LKirchber/3D-printed-Hand/Bilder/Spule.jpg

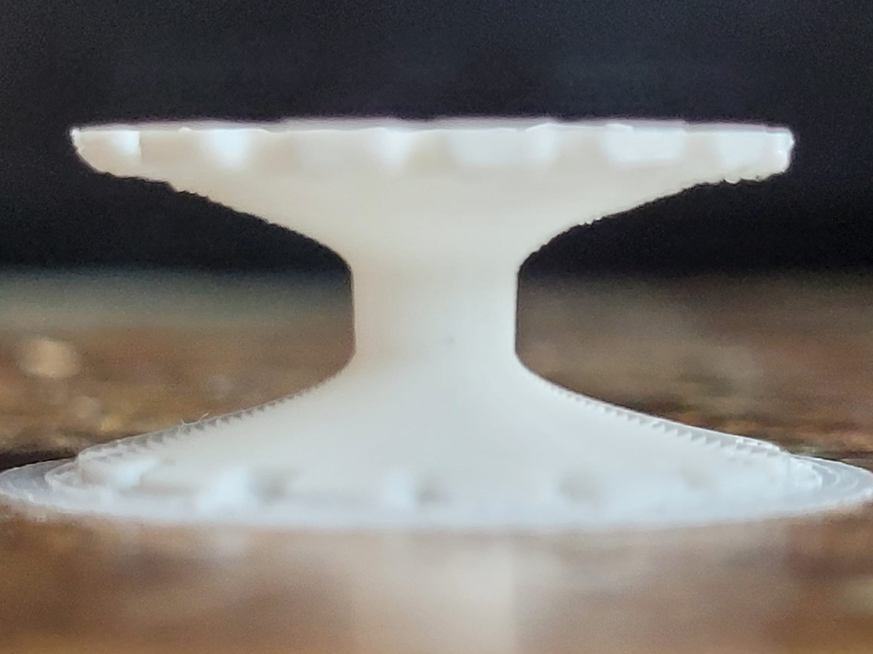
Bilder/Spule.jpg
