LKirchber/3D-printed-Hand/Bilder/Drucksensor lose.jpg

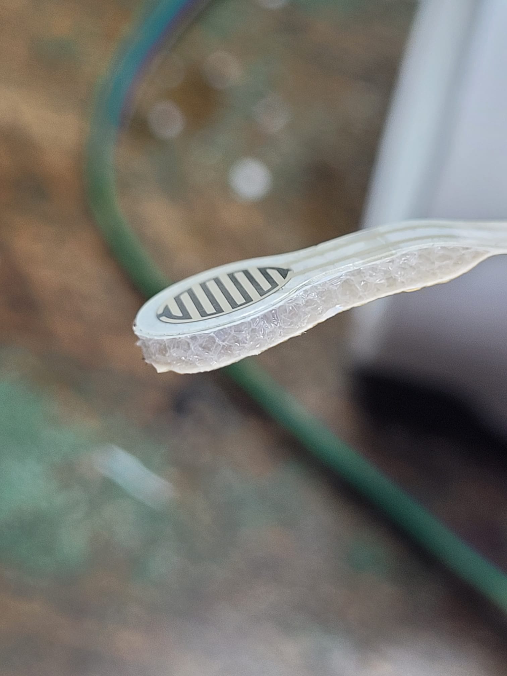
Bilder/Drucksensor lose.jpg
