LKirchber/3D-printed-Hand/Bilder/Bilder CAD/Finger 1 berührt Daumen.1.jpg

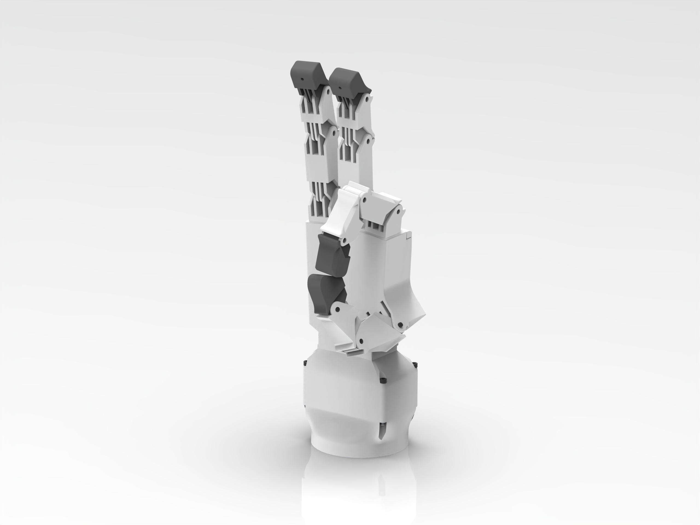
Bilder/Bilder CAD/Finger 1 berührt Daumen.1.jpg
