LKirchber/3D-printed-Hand/Bilder/Bilder CAD/Finger 2 berüht Daumen.1.jpg

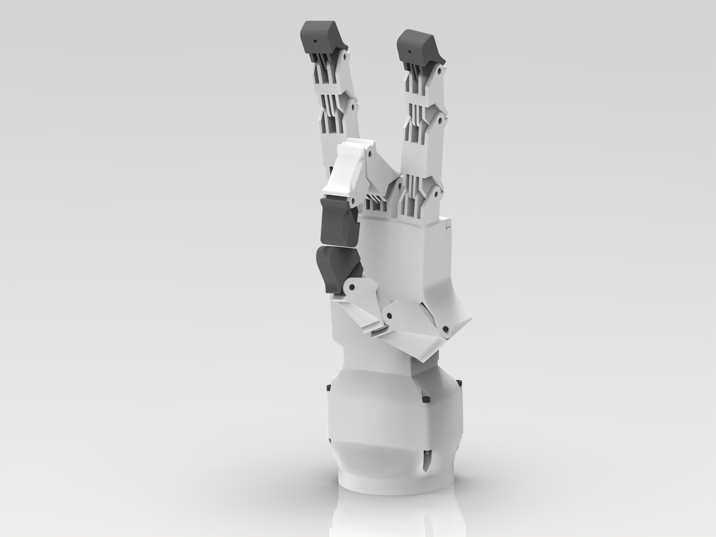
Bilder/Bilder CAD/Finger 2 berüht Daumen.1.jpg
