LKirchber/3D-printed-Hand/Bilder/Bilder CAD/Finger 3 berührt Daumen.1.jpg

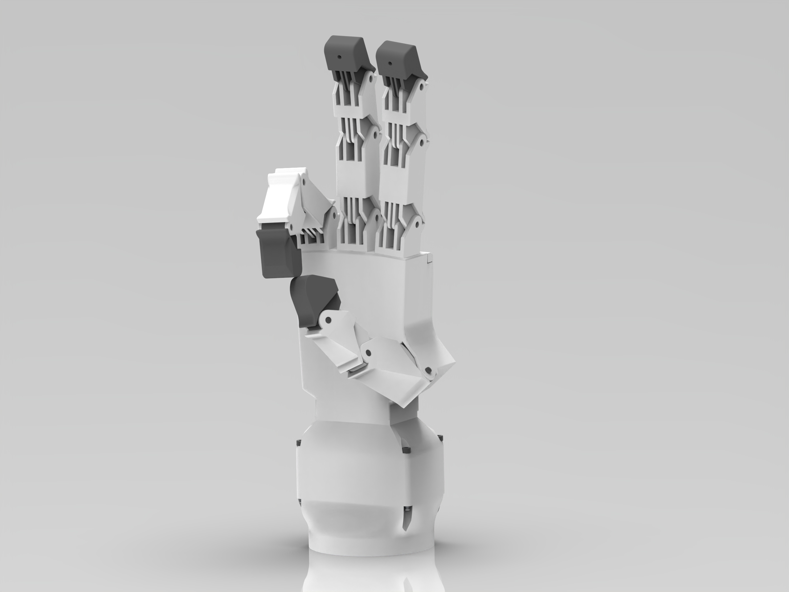
Bilder/Bilder CAD/Finger 3 berührt Daumen.1.jpg
