LKirchber/3D-printed-Hand/Bilder/Bilder CAD/Finger berühren Daumen.2.jpg

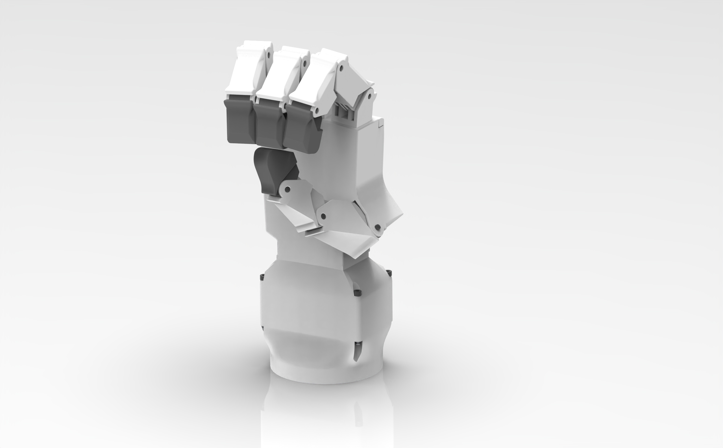
Bilder/Bilder CAD/Finger berühren Daumen.2.jpg
