LKirchber/3D-printed-Hand/Bilder/Bilder CAD/Hand ausgeklappt.1.jpg

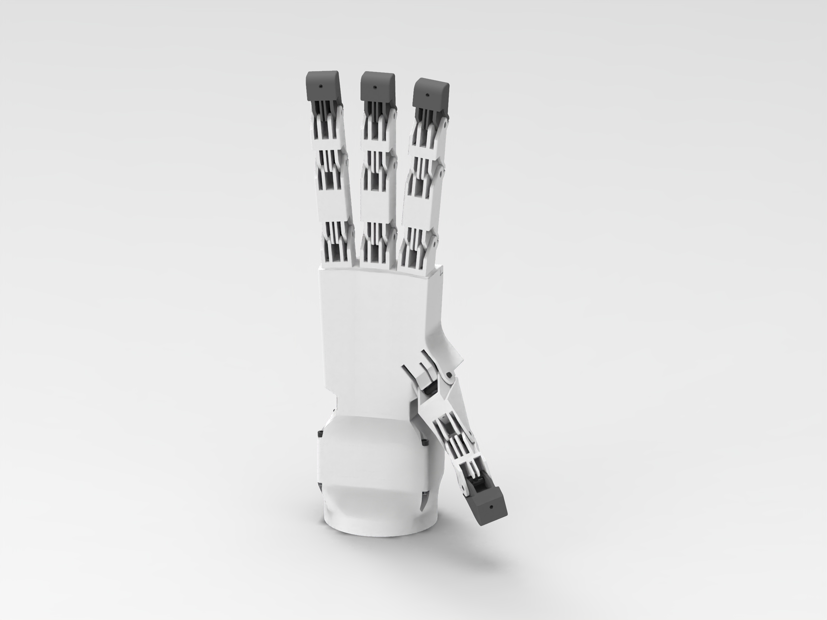
Bilder/Bilder CAD/Hand ausgeklappt.1.jpg
