LKirchber/3D-printed-Hand/Bilder/Bilder CAD/Hand geschlossen.1.jpg

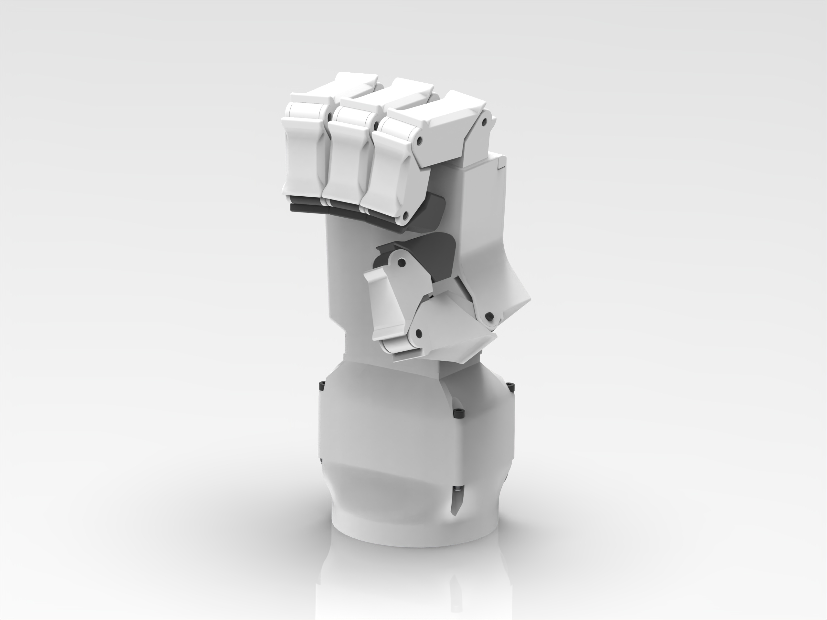
Bilder/Bilder CAD/Hand geschlossen.1.jpg
