LKirchber/3D-printed-Hand/Bilder/Bilder CAD/Hand Grundkörper.1.jpg

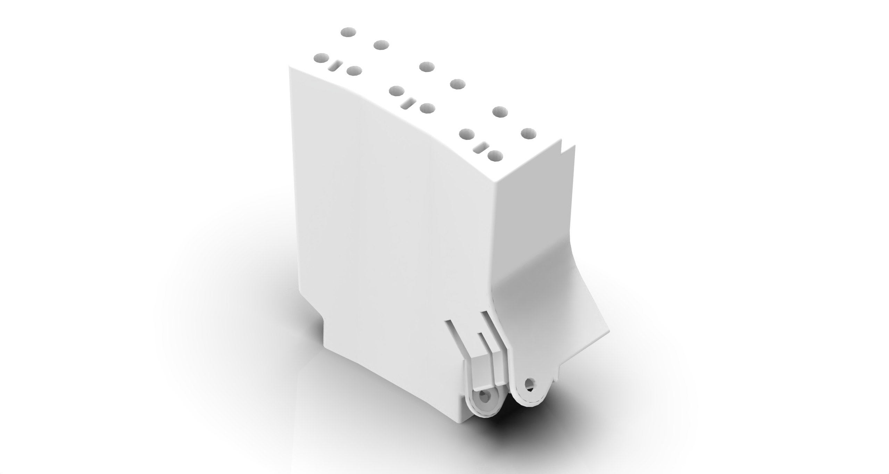
Bilder/Bilder CAD/Hand Grundkörper.1.jpg
