LKirchber/3D-printed-Hand/Bilder/Bilder CAD/Hand offen.1.jpg

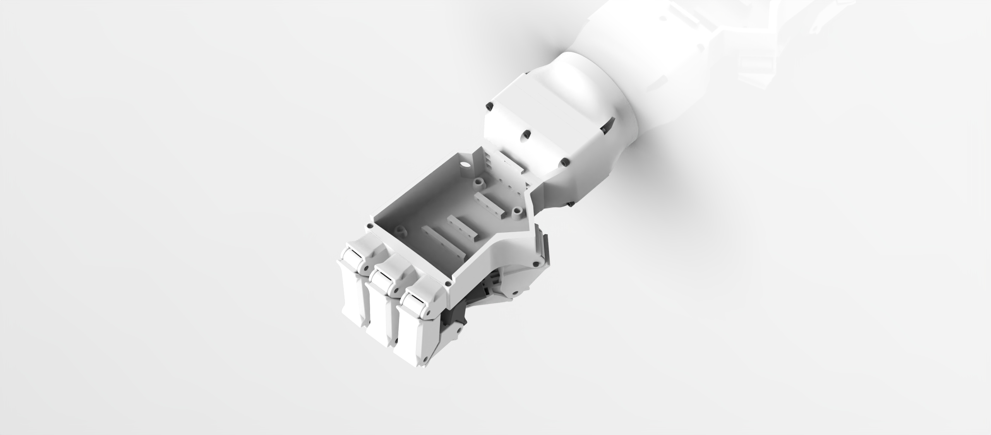
Bilder/Bilder CAD/Hand offen.1.jpg
