LKirchber/3D-printed-Hand/Bilder/Bilder CAD/Hand von hinten.1.jpg

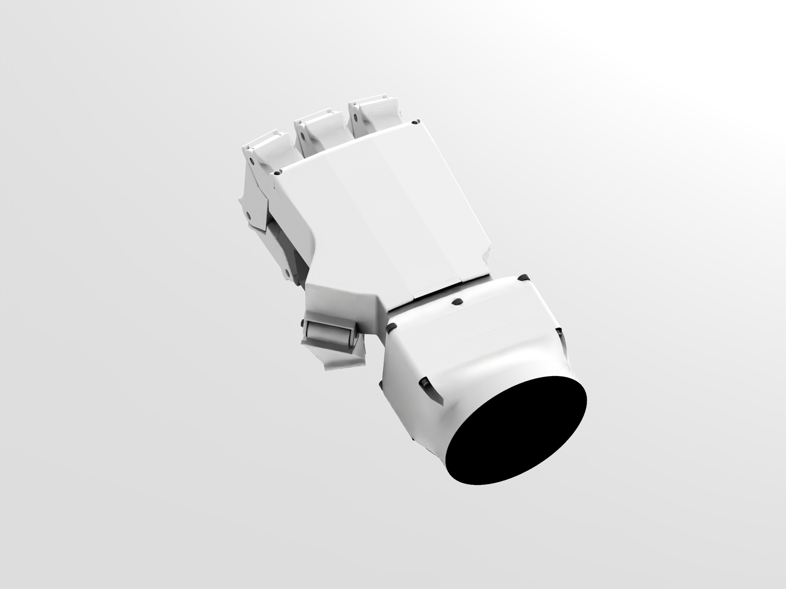
Bilder/Bilder CAD/Hand von hinten.1.jpg
