LKirchber/3D-printed-Hand/Bilder/Bilder CAD/selbst-bau-hand.jpg

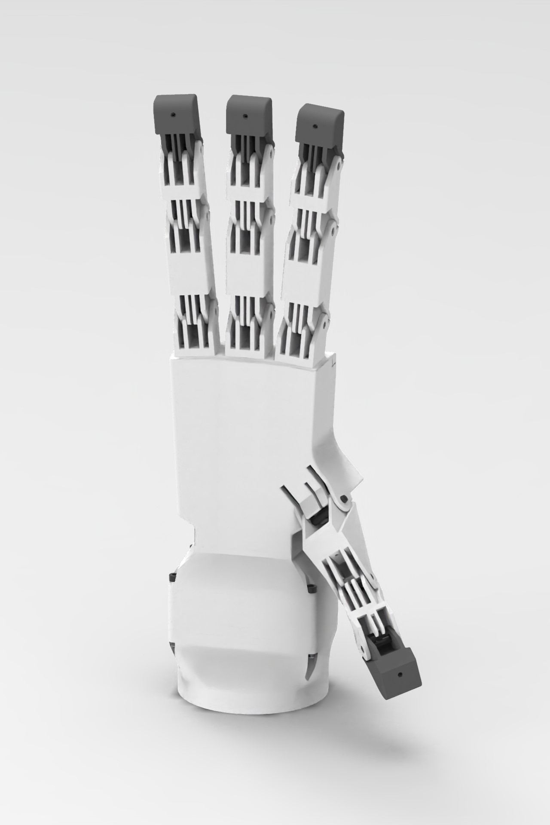
Bilder/Bilder CAD/selbst-bau-hand.jpg
