LKirchber/3D-printed-Hand/Bilder/Gewindeeinsatz.jpg

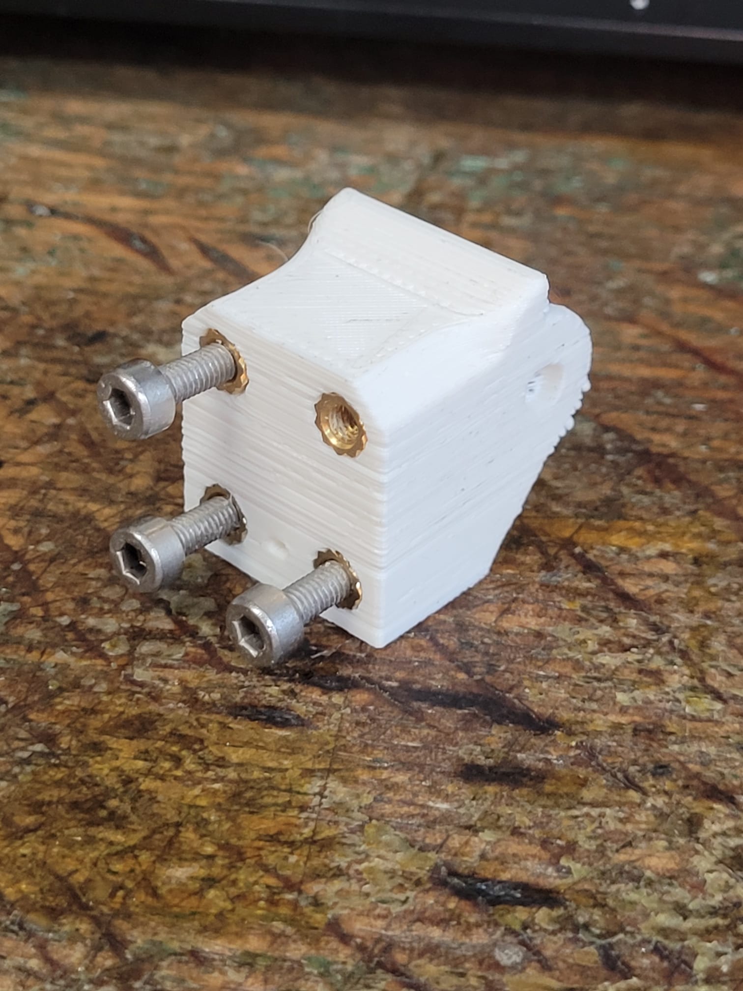
Bilder/Gewindeeinsatz.jpg
