LKirchber/3D-printed-Hand/Bilder/Verkabelung.jpg

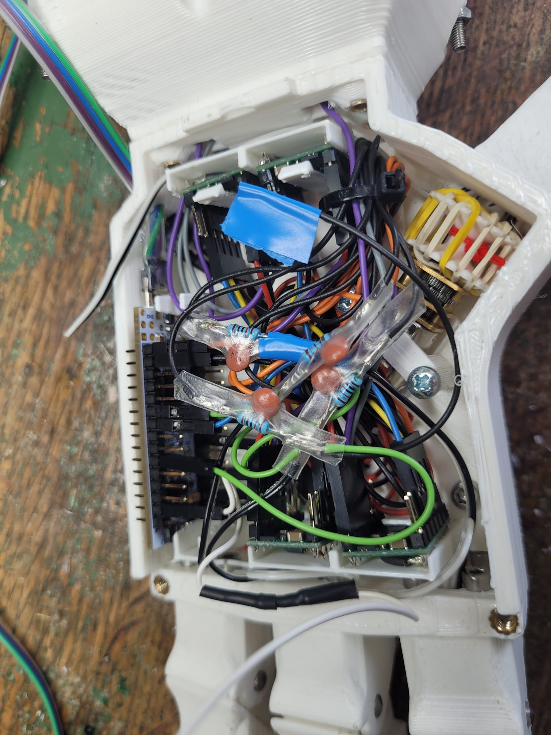
Bilder/Verkabelung.jpg
