LKirchber/3D-printed-Hand/schematics/scematics.png

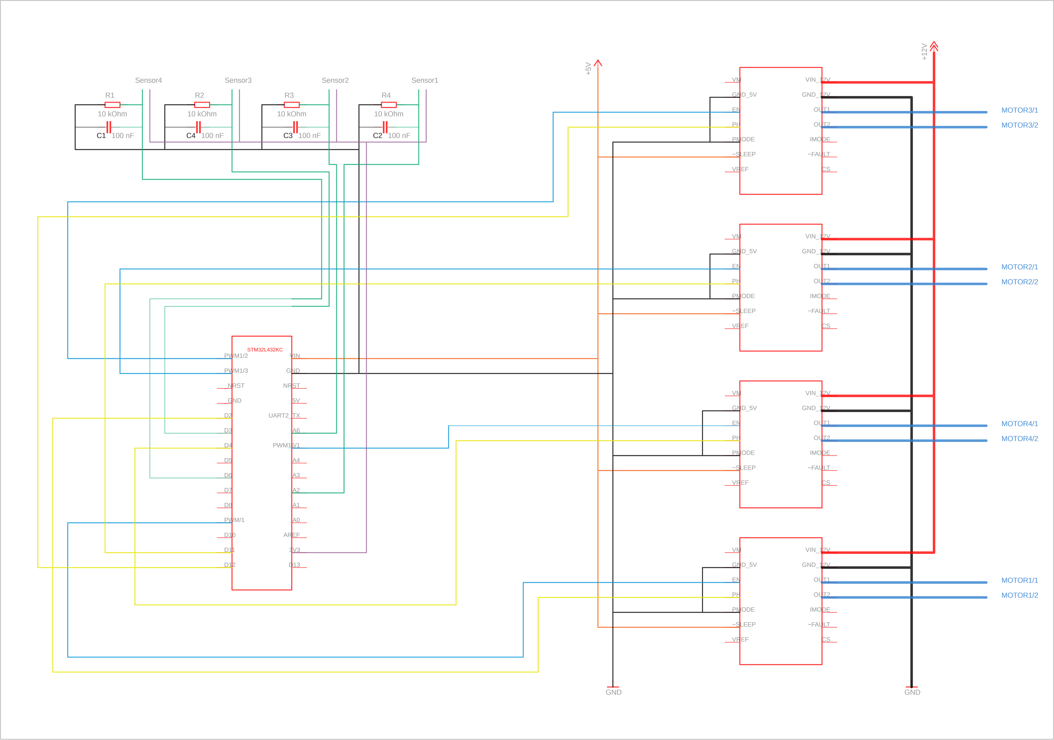
schematics/scematics.png
