LKirchber/3D-printed-Hand/CAD_selbstbau_hand/Daumen 4_Konzept 4-2.stp

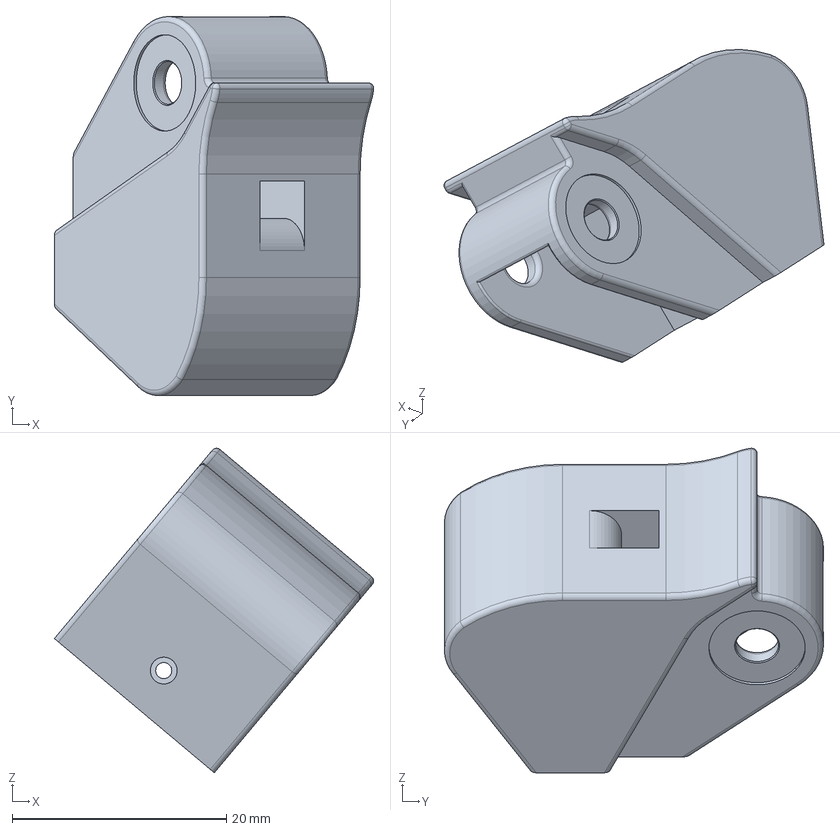
[picture p36: CAD file, 2023-01-17]
CAD_selbstbau_hand/Daumen 4_Konzept 4-2.stp
29.8 x 35.4 x 30.3 mm
