LKirchber/3D-printed-Hand/CAD_selbstbau_hand/hinge gen01 female.stp

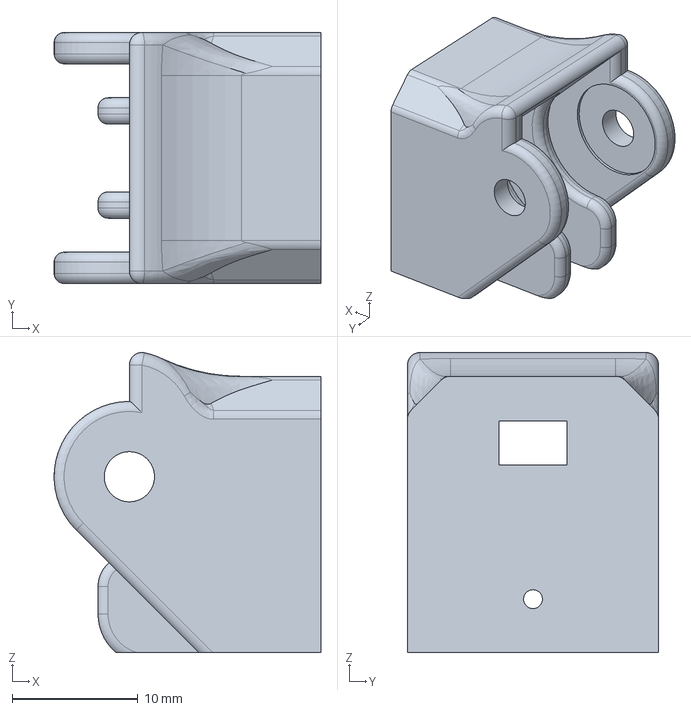
[picture p37: CAD file, 2023-01-17]
CAD_selbstbau_hand/hinge gen01 female.stp
21.2 x 20.0 x 23.9 mm
