LKirchber/3D-printed-Hand/CAD_selbstbau_hand/federhalter.stp

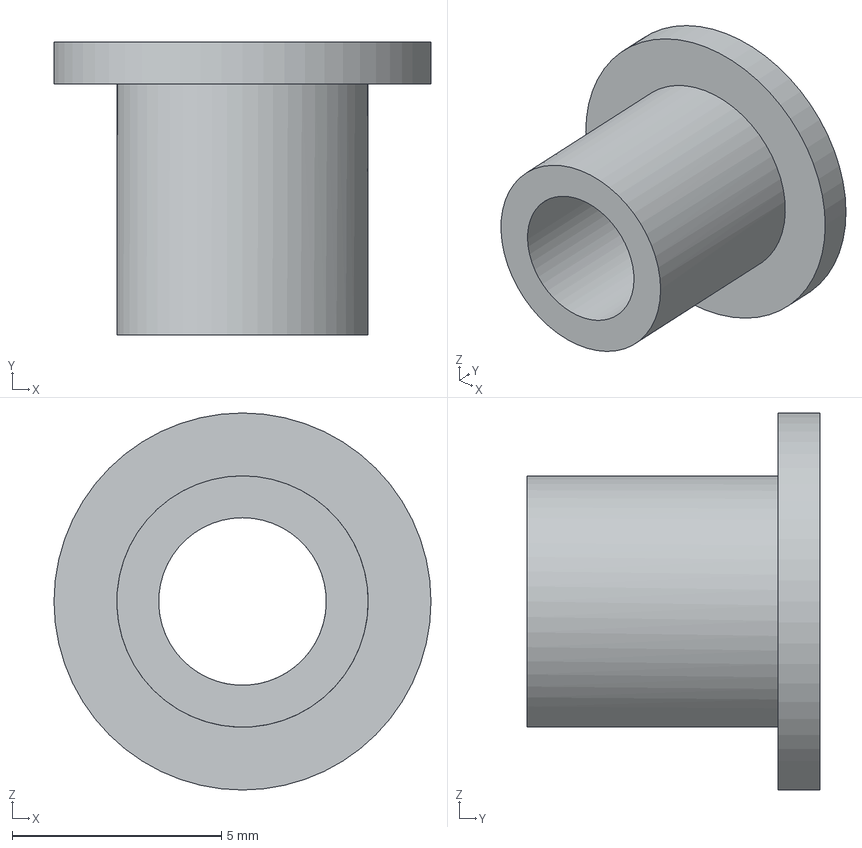
[picture p38: CAD file, 2023-01-17]
CAD_selbstbau_hand/federhalter.stp
9.00 x 7.00 x 9.00 mm
