LKirchber/3D-printed-Hand/CAD_selbstbau_hand/motorhalter.stp

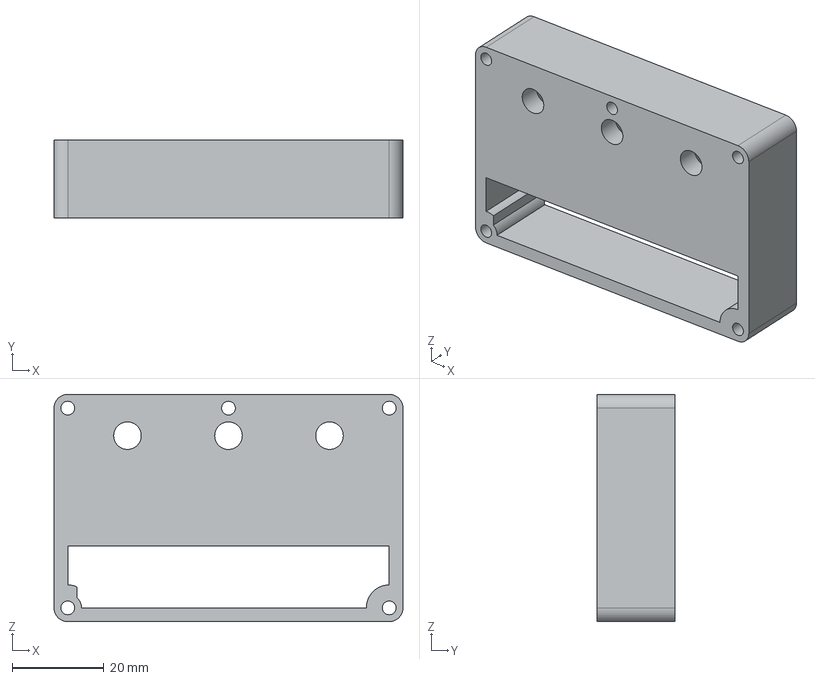
[picture p39: CAD file, 2023-01-17]
CAD_selbstbau_hand/motorhalter.stp
76.0 x 17.0 x 49.5 mm
