LKirchber/3D-printed-Hand/CAD_selbstbau_hand/Hand_Deckel_Konzept 2 (1).stp

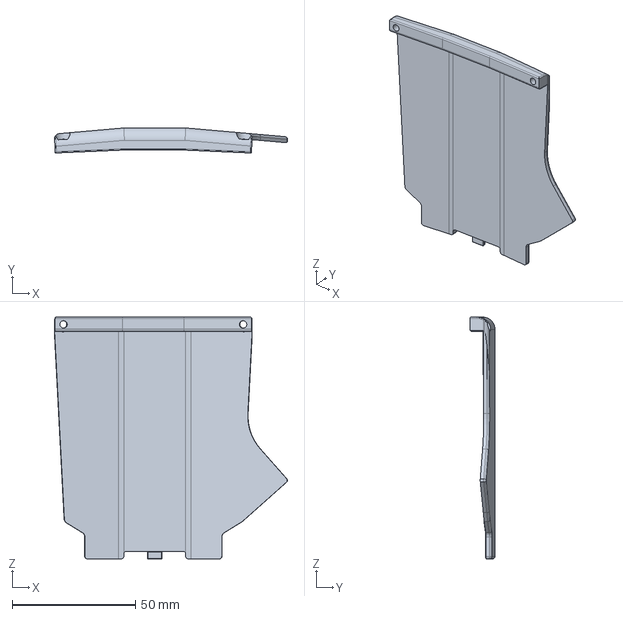
[picture p41: CAD file, 2023-01-17]
CAD_selbstbau_hand/Hand_Deckel_Konzept 2 (1).stp
94.3 x 10.2 x 97.9 mm
