LKirchber/3D-printed-Hand/CAD_selbstbau_hand/Hand_Zwischenebene (1).stp

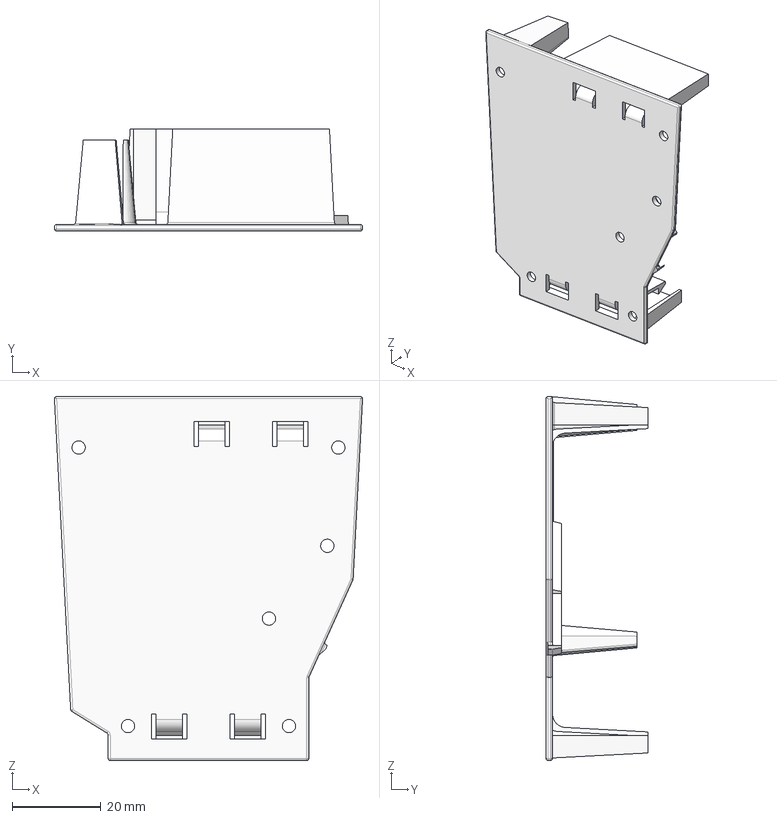
[picture p42: CAD file, 2023-01-17]
CAD_selbstbau_hand/Hand_Zwischenebene (1).stp
69.4 x 23.0 x 82.0 mm
