LKirchber/3D-printed-Hand/CAD_selbstbau_hand/r2_distalis_gen01.1.stp

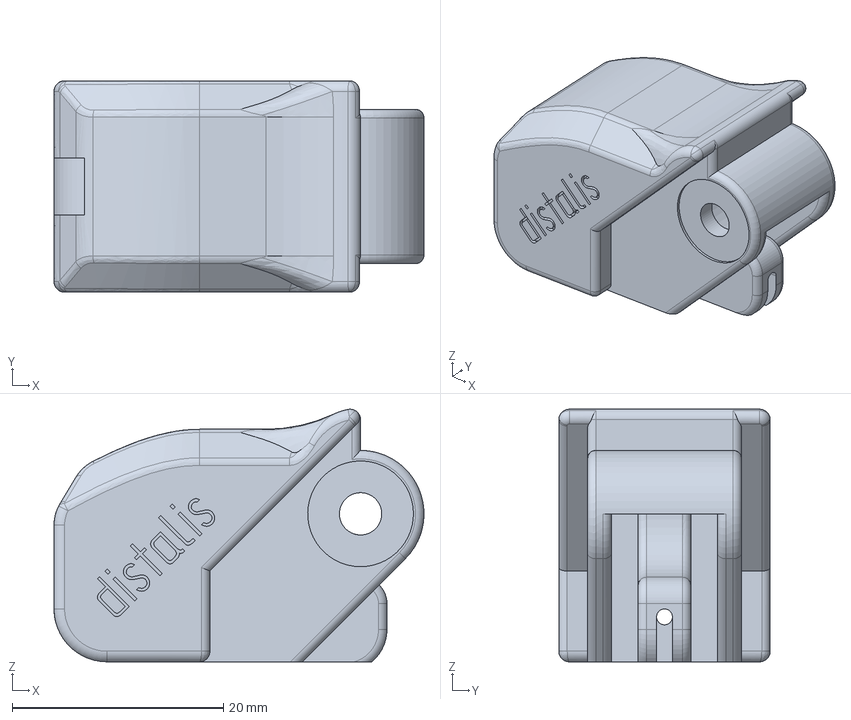
[picture p43: CAD file, 2023-01-17]
CAD_selbstbau_hand/r2_distalis_gen01.1.stp
35.0 x 20.0 x 23.9 mm
