LKirchber/3D-printed-Hand/CAD_selbstbau_hand/motorhalter2.stp

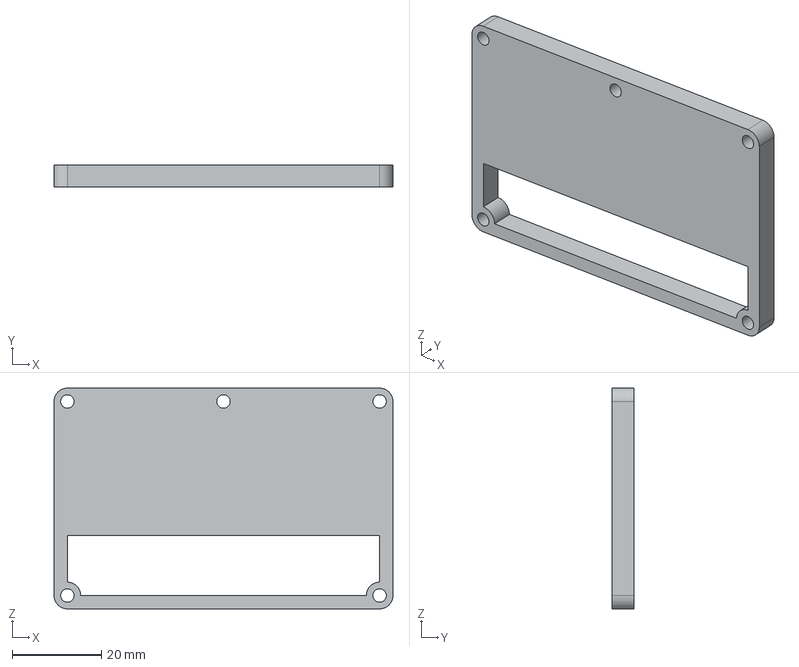
[picture p44: CAD file, 2023-01-17]
CAD_selbstbau_hand/motorhalter2.stp
76.0 x 5.00 x 49.5 mm
