LKirchber/3D-printed-Hand/CAD_selbstbau_hand/Daumen 3_Konzept 3-2.stp

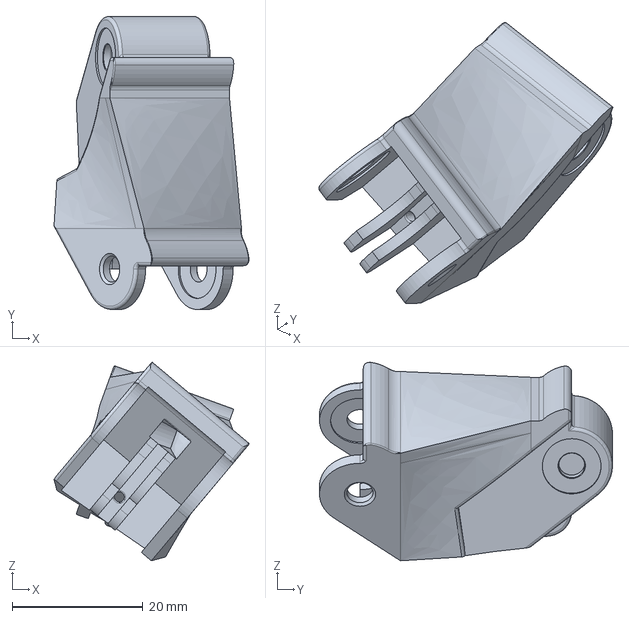
[picture p45: CAD file, 2023-01-17]
CAD_selbstbau_hand/Daumen 3_Konzept 3-2.stp
29.9 x 44.9 x 30.4 mm
