LKirchber/3D-printed-Hand/CAD_selbstbau_hand/Daumen 2_Konzept 3-2.stp

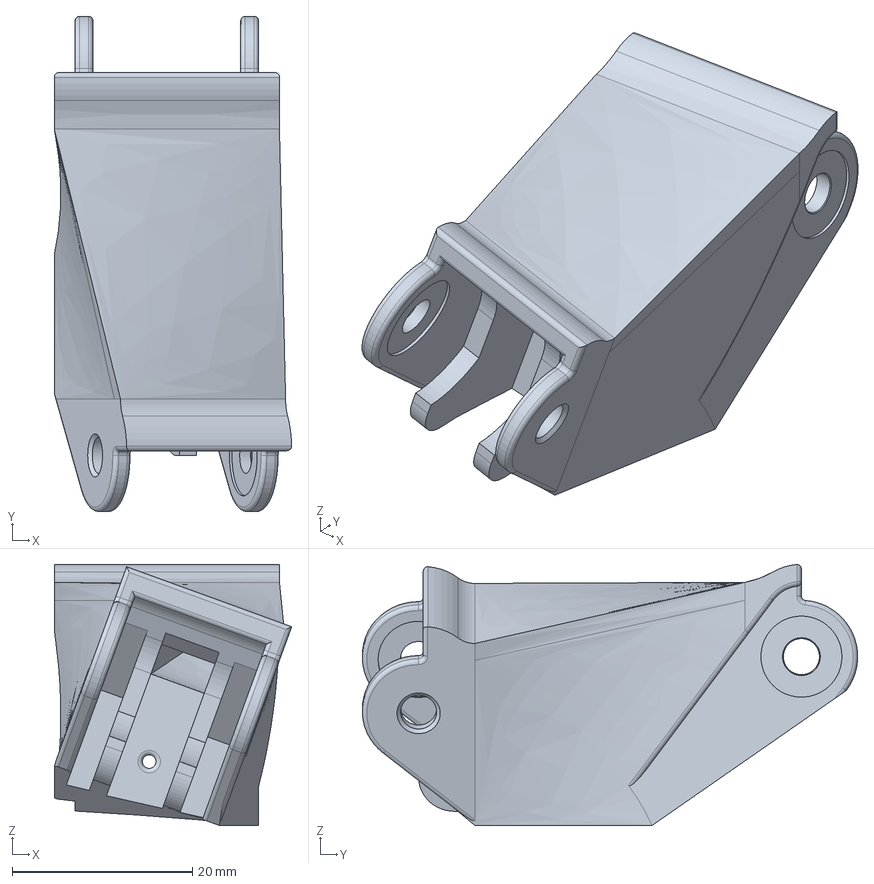
[picture p46: CAD file, 2023-01-17]
CAD_selbstbau_hand/Daumen 2_Konzept 3-2.stp
26.4 x 55.0 x 29.0 mm
