LKirchber/3D-printed-Hand/CAD_selbstbau_hand/r2_proximalis_gen01.1.stp

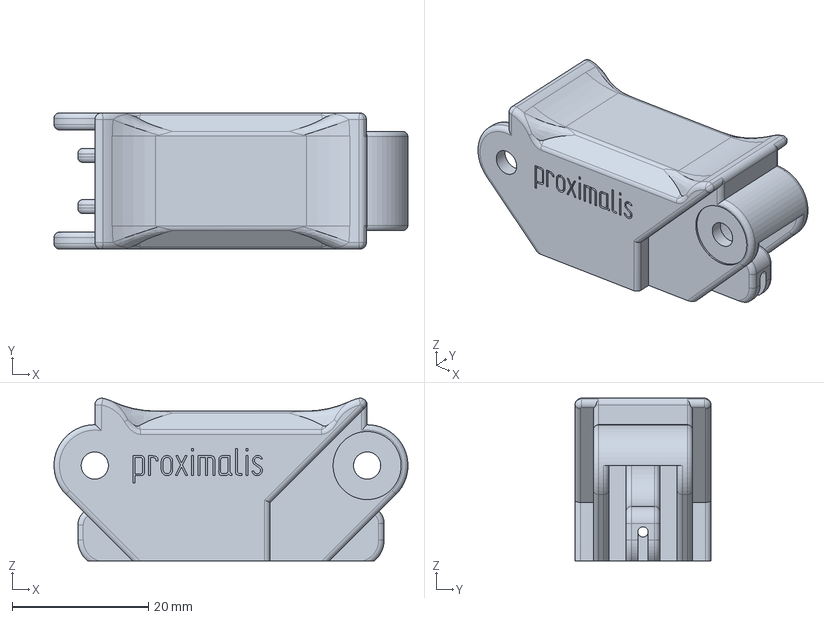
[picture p48: CAD file, 2023-01-17]
CAD_selbstbau_hand/r2_proximalis_gen01.1.stp
52.0 x 20.0 x 23.9 mm
