LKirchber/3D-printed-Hand/CAD_selbstbau_hand/anbindung hand.stp

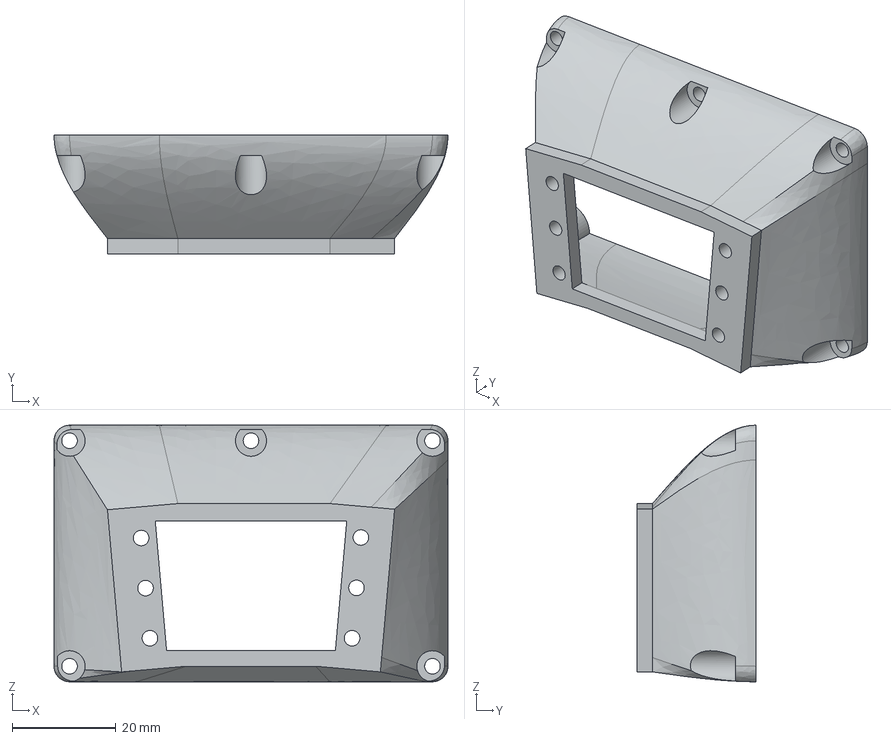
[picture p49: CAD file, 2023-01-17]
CAD_selbstbau_hand/anbindung hand.stp
76.0 x 23.0 x 49.5 mm
