LKirchber/3D-printed-Hand/CAD_selbstbau_hand/hinge gen01.1 female anschraubung.stp

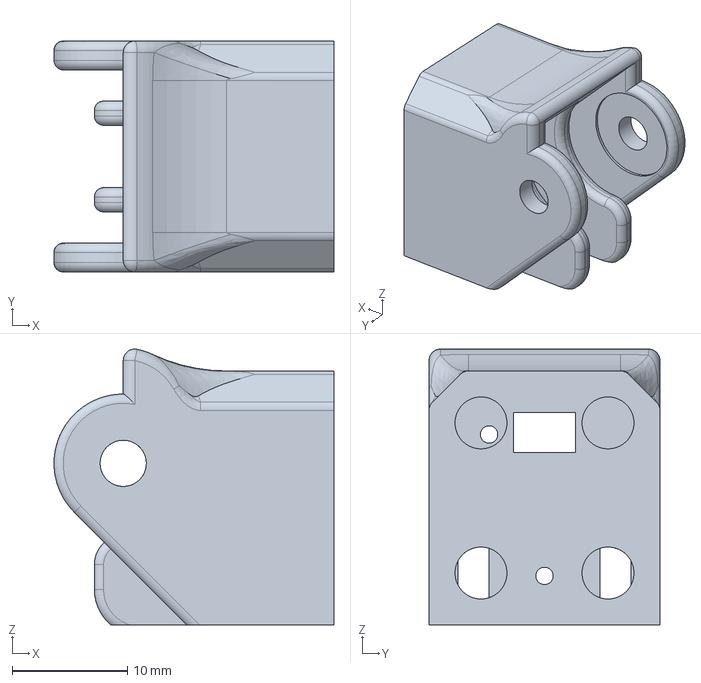
[picture p50: CAD file, 2023-01-17]
CAD_selbstbau_hand/hinge gen01.1 female anschraubung.stp
24.2 x 20.0 x 23.9 mm
