LKirchber/3D-printed-Hand/CAD_selbstbau_hand/Hand_Konzept 3 (3).stp

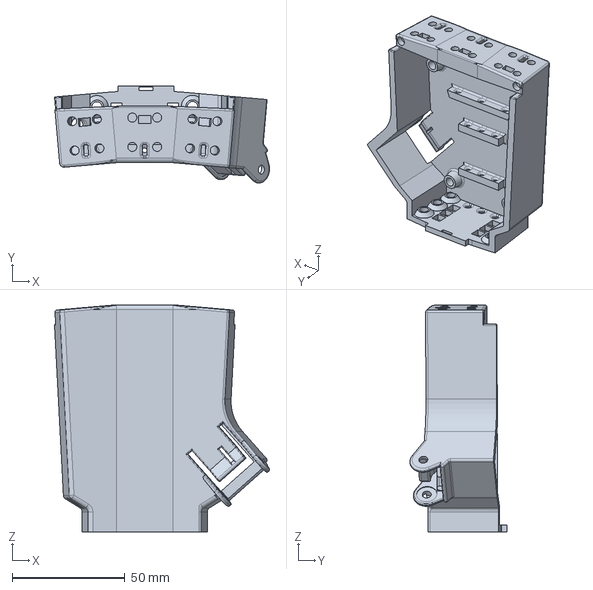
[picture p51: CAD file, 2023-01-17]
CAD_selbstbau_hand/Hand_Konzept 3 (3).stp
95.2 x 43.0 x 100.4 mm
