LKirchber/3D-printed-Hand/CAD_selbstbau_hand/anbindung arm.stp

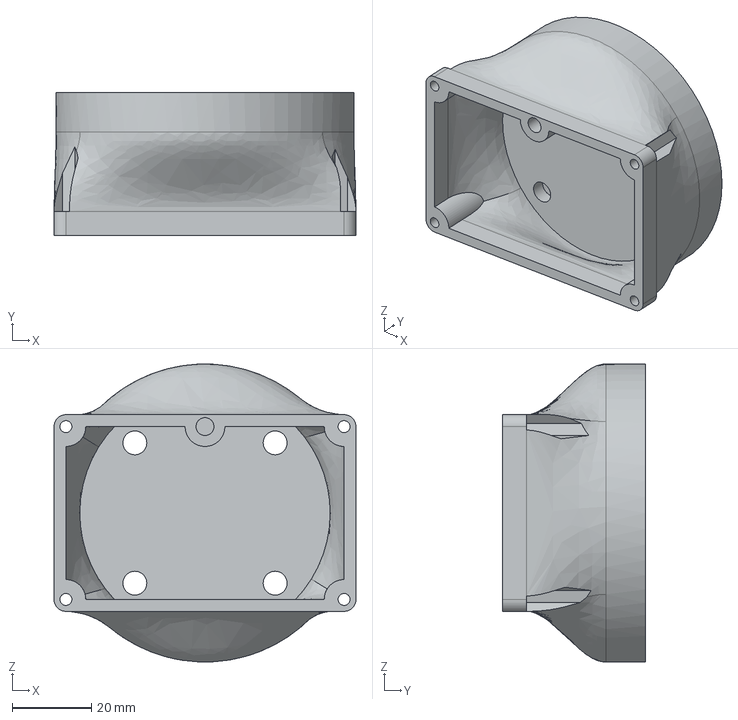
[picture p52: CAD file, 2023-01-17]
CAD_selbstbau_hand/anbindung arm.stp
76.0 x 36.0 x 74.9 mm
