LKirchber/3D-printed-Hand/Core/Src/main.c

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
/* Includes ------------------------------------------------------------------*/
#include "main.h"

/* USER CODE BEGIN Includes */

#include "hand_functions.h"

/* USER CODE END Includes */

ADC_HandleTypeDef hadc1;
DMA_HandleTypeDef hdma_adc1;

TIM_HandleTypeDef htim1;
TIM_HandleTypeDef htim6;
TIM_HandleTypeDef htim16;

UART_HandleTypeDef huart2;

/* USER CODE BEGIN PV */
extern MOTOR_T Motor1;
extern MOTOR_T Motor2;
extern MOTOR_T Motor3;
extern MOTOR_T Motor4;

/* USER CODE END PV */

void SystemClock_Config(void);
static void MX_GPIO_Init(void);
static void MX_DMA_Init(void);
static void MX_USART2_UART_Init(void);
static void MX_ADC1_Init(void);
static void MX_TIM1_Init(void);
static void MX_TIM6_Init(void);
static void MX_TIM16_Init(void);
/**
 * @brief  The application entry point.
 * @retval int
 */
int main(void) {
	/* MCU Configuration--------------------------------------------------------*/

	/* Reset of all peripherals, Initializes the Flash interface and the Systick. */
	HAL_Init();

	/* Configure the system clock */
	SystemClock_Config();

	/* Initialize all configured peripherals */
	MX_GPIO_Init();
	MX_DMA_Init();
	MX_USART2_UART_Init();
	MX_ADC1_Init();
	MX_TIM1_Init();
	MX_TIM6_Init();
	MX_TIM16_Init();
	/* USER CODE BEGIN 2 */

	// Initialization of Timers and Callback functions
	hand_functions_init();

	// Control variables
	int32_t control_p = 5; // P-Gain
	int32_t fsen_soll[4] = { 0, 0, 0, 0 }; 	// Set points
	int32_t fsen_ist[4] = { 0, 0, 0, 0 }; 	// Sensor values
	int32_t pwm[4] = { 0, 0, 0, 0 };// Control values (Duty Cycle in parts of 1000)

	uint32_t time[4] = { 0, 0, 0, 0 };// individual counting variables. Stops when equal 1.
	uint32_t ftime[] = { FTIME1, FTIME2, FTIME3, FTIME4 }; // Empirically gained time values to open  with full speed after been closed

	// State variable
	uint8_t onc = 0;

	// Command variables
	receive = 0;					// UART Interrupt indicator
	int32_t f = 0;					// Force command value
	uint16_t t = 0;					// Force command value
	uint16_t command = 0xFFFF;		// command for taking different actions

	// get command via UART (First request)
	HAL_UART_Receive_IT(&huart2, rxBuffer, 10);

	/* USER CODE END 2 */

	/* Infinite loop */
	/* USER CODE BEGIN WHILE */
	while (1) {

		/* wait for Timer interrupt											*
		 * The Program is called in the frequency of Timer6 interrupt		*/
		if (timestep == 1) {

			/* Check for new command						*
			 * If a new command has been received			*/
			if (receive == 1) {

				// Read new command values into variables
				read_msg_force(&command, &f, &t);

				///////////////// update fsen_soll, time and onc  /////////////////////

				switch (command) {

				/* Close and open all fingers into defalut position
				 * f and t are not used
				 * time is (1.5 * the time to open the hand)
				 * the fingers will be controlled to stop when f is reached
				 */
				case 0:
					onc = 1;
					for (uint8_t k = 0; k < 4; k++) {
						time[k] = (2 * ftime[k]);
						fsen_soll[k] = 0;
					}
					break;

					// Control finger1
				case 1:
					time[0] = t + 1;
					fsen_soll[0] = force_to_sensor(f, SENSOR1);
					break;

					// Control finger2
				case 2:
					time[1] = t + 1;
					fsen_soll[1] = force_to_sensor(f, SENSOR2);
					break;

					// Control finger3
				case 3:
					time[2] = t + 1;
					fsen_soll[2] = force_to_sensor(f, SENSOR3);
					break;

					// Control finger4
				case 4:
					time[3] = t + 1;
					fsen_soll[3] = force_to_sensor(f, SENSOR4);
					break;

					// Control all fingers
				case 5:
					for (uint8_t k = 0; k < 4; k++) {
						time[k] = t + 1;
						fsen_soll[k] = force_to_sensor(f, (SENSOR) k);
					}
					break;

					// Control finger 1 and 4
				case 6:
					time[0] = t + 1;
					time[3] = t + 1;

					fsen_soll[0] = force_to_sensor(f, SENSOR1);
					fsen_soll[3] = force_to_sensor(f, SENSOR4);
					break;

					// Control finger 2 and 4
				case 7:
					time[1] = t + 1;
					time[3] = t + 1;

					fsen_soll[1] = force_to_sensor(f, SENSOR2);
					fsen_soll[3] = force_to_sensor(f, SENSOR4);
					break;

					// Control finger 3 and 4
				case 8:
					time[2] = t + 1;
					time[3] = t + 1;

					fsen_soll[2] = force_to_sensor(f, SENSOR3);
					fsen_soll[3] = force_to_sensor(f, SENSOR4);
					break;

					// Control finger 1,2 and 3
				case 9:
					time[0] = t + 1;
					time[1] = t + 1;
					time[2] = t + 1;

					fsen_soll[0] = force_to_sensor(f, SENSOR1);
					fsen_soll[1] = force_to_sensor(f, SENSOR2);
					fsen_soll[2] = force_to_sensor(f, SENSOR4);
					break;

					/* Close and open all fingers into defalut position
					 * f and t are not used
					 * time is (1.5 * the time to open the hand)
					 * the fingers will be controlled to stop when f is reached
					 */
				case 10:
					onc = 1;
					for (uint8_t k = 0; k < 4; k++) {
						time[k] = (2 *ftime[k]);
						fsen_soll[k] = 0;
					}
					break;

					// Open finger 1
				case 11:
					time[0] = t + 1;
					onc = 2;
					pwm[0] = -1 * f;
					break;

					// Open finger 2
				case 12:
					time[1] = t + 1;
					onc = 2;
					pwm[1] = -1 * f;
					break;

					// Open finger 3
				case 13:
					time[2] = t + 1;
					onc = 2;
					pwm[2] = -1 * f;
					break;

					// Open finger 4
				case 14:
					time[3] = t + 1;
					onc = 2;
					pwm[3] = -1 * f;
					break;

					// Open all fingers
				case 15:
					onc = 2;
					for (uint8_t k = 0; k < 4; k++) {
						time[k] = t + 1;
						pwm[k] = -1 * f;
					}
					break;

					// Open finger 1 and 4
				case 16:
					onc = 2;
					time[0] = t + 1;
					time[3] = t + 1;

					pwm[0] = -1 * f;
					pwm[3] = -1 * f;
					break;

					// Control finger 2 and 4
				case 17:
					onc = 2;
					time[1] = t + 1;
					time[3] = t + 1;

					pwm[1] = -1 * f;
					pwm[3] = -1 * f;
					break;

					// Open finger 3 and 4
				case 18:
					onc = 2;
					time[2] = t + 1;
					time[3] = t + 1;

					pwm[2] = -1 * f;
					pwm[3] = -1 * f;
					break;

					// Open finger 1,2 and 3
				case 19:
					onc = 2;
					time[0] = t + 1;
					time[1] = t + 1;
					time[2] = t + 1;

					pwm[0] = -1 * f;
					pwm[1] = -1 * f;
					pwm[2] = -1 * f;
					break;

				default:
					onc = 0;
					for (uint8_t k = 0; k < 4; k++) {
						time[k] = 0;
						fsen_soll[k] = 0;
					}
				}

				receive = 0;

			} // End read msg

			//////////////////////// Pull sensor values //////////////////////////

			get_all_sensors(fsen_ist);

			////////////////////////   Motor control   /////////////////////////

			/* onc = 0 -> P-Control
			 * onc = 1 -> Close and Open Hand
			 * onc >= 2 -> continues motion until time is up
			 */
			if (onc == 0) {
				// P-Control
				for (uint8_t j = 0; j < 4; j++) {
					pwm[j] = control_p * (fsen_soll[j] - fsen_ist[j]);
				}
			} else if (onc == 1) {
				// Close and Open
				for (uint8_t j = 0; j < 4; j++) {

					pwm[j] = 700;
				}
				// If all Fingers are closed open them with max Speed
				if (time[0] <= 1 && time[1] <= 1 && time[2] <= 1
						&& time[3] <= 1) {
					for (uint8_t j = 0; j < 4; j++) {
						pwm[j] = -1000;
						time[j] = ftime[j];
						onc = 2;
					}
				}
			} else if (time[0] <= 1 && time[1] <= 1 && time[2] <= 1
					&& time[3] <= 1) {
				// Wait till Open to start new Control
				onc = 0;
			}

			////////////////////// Set Motors //////////////////////////
			SetMotors(pwm, time);

			/////////////////////// Send Data //////////////////////////

			if (time[0] > 1 || time[1] > 1 || time[2] > 1 || time[3] > 1) {
				int32_t temp_forces[4];
				sensors_to_forces(fsen_ist, temp_forces);
				// transmit Sensordata
				snprintf(txBuf, 64,"pwm: \t%d\t%d\t%d\t%d \tforce: \t%d\t%d\t%d\t%d \r\n",(int) pwm[0], (int) pwm[1], (int) pwm[2], (int) pwm[3],(int) temp_forces[0], (int) temp_forces[1],(int) temp_forces[2], (int) temp_forces[3]);
				//snprintf(txBuf, 64,"pwm: \t%d\t%d\t%d\t%d \tforce: \t%d\t%d\t%d\t%d \r\n",(int) pwm[0], (int) pwm[1], (int) pwm[2], (int) pwm[3],(int) fsen_ist[0], (int) fsen_ist[1],(int) fsen_ist[2], (int) fsen_ist[3]);
				HAL_UART_Transmit(&huart2, (uint8_t*) txBuf, strlen(txBuf),
						HAL_MAX_DELAY);
			}

			// reset timestep
			timestep = 0;

		} else {
			// Set ONBOARD_LED HIGH when slope to slow
			HAL_GPIO_WritePin(GPIOB, GPIO_PIN_3, GPIO_PIN_RESET);

		} // End timestep

	}
	/* USER CODE END WHILE */

}

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
