LKirchber/3D-printed-Hand/Core/Inc/main.h

#define MOTOR1_PH_Pin GPIO_PIN_12
#define MOTOR1_PH_GPIO_Port GPIOA
#define BUILTIN_LED_Pin GPIO_PIN_3
#define BUILTIN_LED_GPIO_Port GPIOB
#define MOTOR2_PH_Pin GPIO_PIN_4
#define MOTOR2_PH_GPIO_Port GPIOB
#define MOTOR3_PH_Pin GPIO_PIN_5
#define MOTOR3_PH_GPIO_Port GPIOB
#define MOTOR4_PH_Pin GPIO_PIN_7
#define MOTOR4_PH_GPIO_Port GPIOB
